ThomasHeb/Jog-for-Estelcam/img/1.png

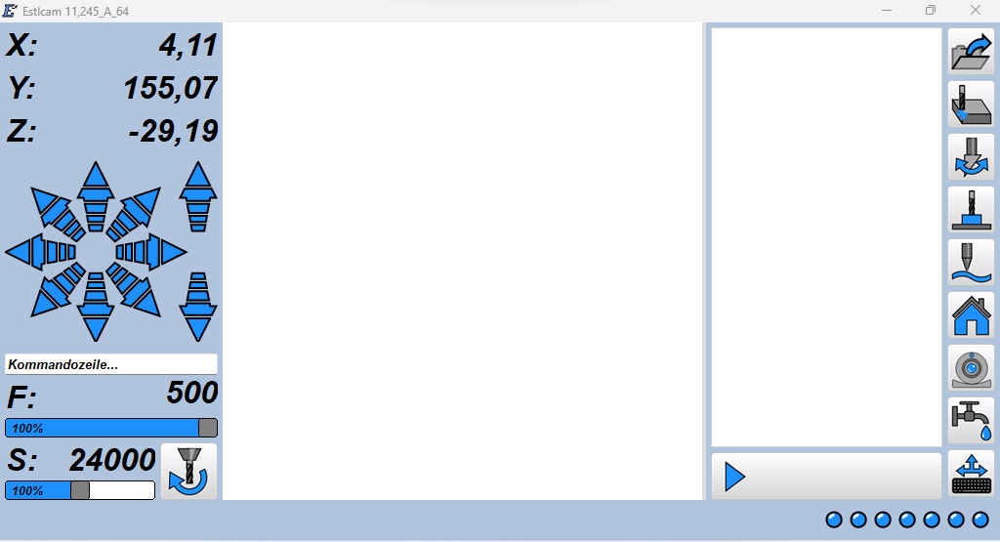
img/1.png
