ThomasHeb/Jog-for-Estelcam/img/2.png

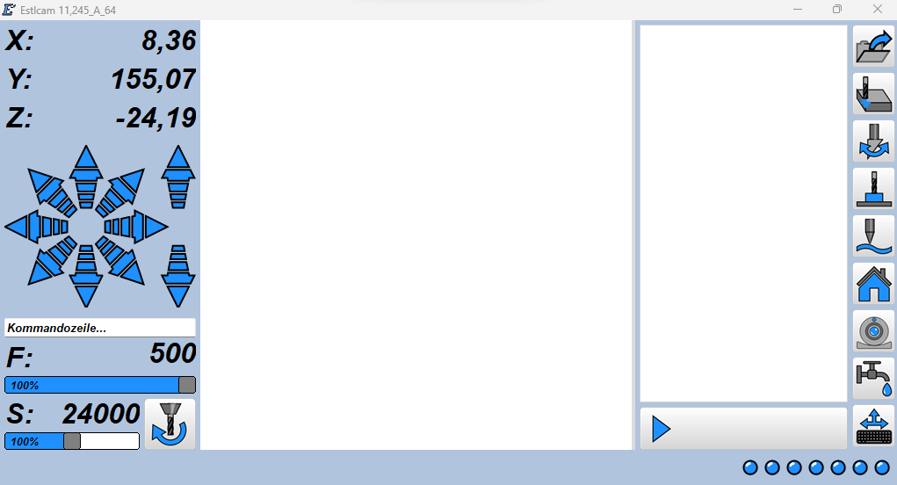
img/2.png
