ThomasHeb/Jog-for-Estelcam/img/5.jpg

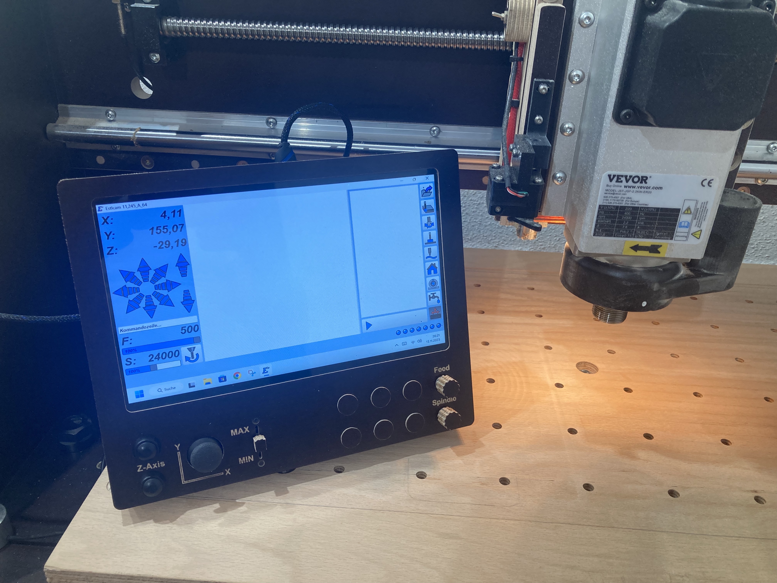
img/5.jpg
